whensungoesdown/soc1/tb/testasmcode.txt

addi x5, x0, 0
addi x6, x0, 0
addi x7, x0, 100

loop:
addi x6, x6, 1
add x5, x5, x6
bne x6, x7, loop

sw x5, 0x50(x0)
addi x0, x0, 0
addi x0, x0, 0
halt:
addi x0, x0, 0
beq x0,x0, halt
