whensungoesdown/soc1/soc/cpu6/cpu6_core.v

`include "defines.v"

module cpu6_core (
   input  clk,
   input  reset,

   output [`CPU6_XLEN-1:0] pcF,
   input  [`CPU6_XLEN-1:0] instr,
   // write back to memory
   output memwriteM,
   output [`CPU6_XLEN-1:0] dataaddr,
   output [`CPU6_XLEN-1:0] writedata,
   // fetch data
   input  [`CPU6_XLEN-1:0] readdata,

   output csr_mtie_r,
   output csr_meie_r,
   input  tmr_irq_r,
   input  ext_irq_r
);

   wire memwrite;
   wire memtoreg;
   wire alusrc;
   //wire regdst;
   wire regwrite;
   wire jump;
   wire [`CPU6_BRANCHTYPE_SIZE-1:0] branchtype;
   wire zero;

   wire [`CPU6_ALUCONTROL_SIZE-1:0] alucontrol;   
   wire alusignext;
   wire [`CPU6_IMMTYPE_SIZE-1:0] immtype;

   wire [`CPU6_XLEN-1:0] instrF;

   wire memwriteE;
   wire memtoregE;
   wire [`CPU6_BRANCHTYPE_SIZE-1:0] branchtypeE;
   wire alusrcE;
   wire regwriteE;
   wire jumpE;
   wire [`CPU6_ALUCONTROL_SIZE-1:0] alucontrolE;
   wire alusignextE;
   wire [`CPU6_IMMTYPE_SIZE-1:0] immtypeE;
   wire [`CPU6_XLEN-1:0] instrE;


   wire [`CPU6_XLEN-1:0] pcplus4F;
   wire [`CPU6_XLEN-1:0] pcnextF;

   wire [`CPU6_XLEN-1:0] pcE;
   wire [`CPU6_XLEN-1:0] pcnextE;
   wire pcsrcE;

   wire hazard_stallF;
   wire empty_pipeline_stallF;
   // empty pipeline
   wire empty_pipeline_req;
   wire empty_pipeline_reqE;
   wire empty_pipeline_ackW;
   

   wire stallF;
   wire flashE;

   wire hazard_flashE;


   wire [`CPU6_LSWIDTH_SIZE-1:0] lswidth;  // for LW LH LB, SW SH SB
   wire loadsignext; // for LHU LBU

   wire [`CPU6_LSWIDTH_SIZE-1:0] lswidthE;  // for LW LH LB, SW SH SB
   wire loadsignextE; // for LHU LBU

   
   wire jal;  // instruction jal, goes to EX
   wire lui;  // instruction lui, goes to EX
   wire auipc; // instruction auipc, goes to EX

   wire jalE;
   wire luiE;
   wire auipcE;
   wire [`CPU6_XLEN-1:0] pc_auipcE;
   
   wire mret;
   
   wire excp_illinstr;
   wire excp_flush_pc_ena;
   wire [`CPU6_XLEN-1:0] excp_flush_pc;

   wire [`CPU6_XLEN-1:0] excp_mepc;
   wire excp_mepc_ena;

   wire [`CPU6_XLEN-1:0] excp_pc;

   wire [`CPU6_XLEN-1:0] csr_mtvec;
   
   wire [`CPU6_XLEN-1:0] csr_mepc;

   wire csr_mstatus_mie_r;

   wire shft_en;
   wire shft_lr;
   wire shft_la;
   
   wire shft_enE;
   wire shft_lrE;
   wire shft_laE;


   
   cpu6_excp excp(
      .clk              (clk     ),
      .reset            (reset   ),
      .excp_pc          (excp_pc ),
      
      .excp_illinstr        (excp_illinstr    ),
      .tmr_irq_r            (tmr_irq_r        ),
      .ext_irq_r            (ext_irq_r        ),
      .csr_mstatus_mie_r    (csr_mstatus_mie_r),
      
      .excp_flush_pc_ena    (excp_flush_pc_ena),
      .excp_flush_pc        (excp_flush_pc    ),
      .excp_mepc            (excp_mepc        ),
      .excp_mepc_ena        (excp_mepc_ena    ),
      .csr_mtvec            (csr_mtvec        )
      );
       

   
   cpu6_hazardcontrol hazardcontrol(branchtype, jump, branchtypeE, jumpE, pcsrcE,
      hazard_stallF, hazard_flashE);


   assign empty_pipeline_stallF = empty_pipeline_req & (~empty_pipeline_ackW);
   
   //assign stallF = hazard_stallF | empty_pipeline_stallF;
   assign stallF = (~excp_flush_pc_ena & (hazard_stallF | empty_pipeline_stallF));


   // for interrupt, after trap handler, the faulting pc will be re-executed
   // so here, since the instruction is already fetched, 
   // Replace it with NOP
   assign instrF = (csr_mstatus_mie_r & (tmr_irq_r | ext_irq_r)) ? `NOP : instr;
   
   assign flashE = hazard_flashE;
   
   cpu6_dfflr#(`CPU6_XLEN) pcreg(!stallF, pcnextF, pcF, ~clk, reset);
   
   // It is a trick, pcF updated in the *falling edge* in order to be ahead of time,
   // so that pcF is ready for the RAM when the rasing edge comes.
   // But other modules such as cpu6_excp still works on the rasing edge.
   // When excp sends the pcF to csr to write, the pcF is already updated in the previous
   // falling edge. So there have to be an extra pc to store the previous pcF value. 
   cpu6_dfflr#(`CPU6_XLEN) excp_pc_reg(!stallF, pcF, excp_pc, ~clk, reset);
   
   cpu6_adder pcadd4(pcF, 32'b100, pcplus4F); // next pc if no branch, no jump
   
  
   
   //cpu6_mux2#(`CPU6_XLEN) pcnextmux(pcplus4F, pcnextE, pcsrcE, pcnextF);
   // 1. excp_flush has the highest priority. For example, illegal instruction, the excp module
   //    need to set pc to trap vector.
   // 2. There is a branch, the branch pc comes from EX stage because it needs calculation
   // 3. pc+4  
   assign pcnextF =
		    mret              ? csr_mepc      :
		    excp_flush_pc_ena ? excp_flush_pc :
		    pcsrcE            ? pcnextE       :
		    pcplus4F;

   assign empty_pipeline_req = mret | excp_flush_pc_ena; // (excp_active);

   // csr
   wire csr;
   wire csr_rs1uimm;
   wire [`CPU6_CSR_WSC_SIZE-1:0] csr_wsc;

   // csr signal pass to datapath IDEX
   wire csrE;
   wire csr_rs1uimmE;
   wire [`CPU6_CSR_WSC_SIZE-1:0] csr_wscE;
   //


   
   cpu6_controller c(
      .op             (instrF[`CPU6_OPCODE_HIGH:`CPU6_OPCODE_LOW]),
      .funct3         (instrF[`CPU6_FUNCT3_HIGH:`CPU6_FUNCT3_LOW]),
      .funct7         (instrF[`CPU6_FUNCT7_HIGH:`CPU6_FUNCT7_LOW]),

      .lswidth        (lswidth        ),
      .loadsignext    (loadsignext    ),
      
      .jal            (jal            ),
      .lui            (lui            ),
      .auipc          (auipc          ),
      .mret           (mret           ),
      // csr
      .csr            (csr            ),
      .csr_rs1uimm    (csr_rs1uimm    ),
      .csr_wsc        (csr_wsc        ),
      //
      .memtoreg       (memtoreg       ),
      .memwrite       (memwrite       ),
      .branchtype     (branchtype     ),
      .alusrc         (alusrc         ),
      .regwrite       (regwrite       ),
      .jump           (jump           ),
      .alucontrol     (alucontrol     ),
      .alusignext     (alusignext     ),
      .immtype        (immtype        ),
      .illinstr       (excp_illinstr  ),

      .shft_en        (shft_en        ),
      .shft_lr        (shft_lr        ),
      .shft_la        (shft_la        )
      );

   
   //
   // To flash the pipeline register, signal flashE. 
   // If no flash pipelinereg_idex, this branch instruction will go through the pipeline
   // twice, so it will branch twice, then the following instruction will also be
   // executed twice.
   // So, need flashE, but not by reset, set an flash signal, it makes a bubble into
   // pipeline_idex in the next clock cycle.
   //
   
   cpu6_pipelinereg_idex pipelinereg_idex(
      .clk              (clk            ),
      .reset            (reset          ),
      .flash            (flashE         ),

      .lswidth          (lswidth        ),
      .loadsignext      (loadsignext    ),
      
      .jal              (jal            ),
      .lui              (lui            ),
      .auipc            (auipc          ),
      .pc_auipc         (excp_pc        ),
      // csr
      .csr              (csr            ),
      .csr_rs1uimm      (csr_rs1uimm    ),
      .csr_wsc          (csr_wsc        ),
      //
      .memwrite         (memwrite       ),
      .memtoreg         (memtoreg       ),
      .branchtype       (branchtype     ),
      .alusrc           (alusrc         ),
      .regwrite         (regwrite       ),
      .jump             (jump           ),
      .alucontrol       (alucontrol     ),
      .alusignext       (alusignext     ),
      .immtype          (immtype        ),
      .pc               (pcF            ),
      .instrF           (instrF         ),
      .empty_pipeline_req  (empty_pipeline_req ),
      
      .shft_en          (shft_en        ),
      .shft_lr          (shft_lr        ),
      .shft_la          (shft_la ),
      

      .lswidthE         (lswidthE       ),
      .loadsignextE     (loadsignextE   ),
      
      .jalE             (jalE           ),
      .luiE             (luiE           ),
      .auipcE           (auipcE         ),
      .pc_auipcE        (pc_auipcE      ),
      // csr
      .csrE             (csrE           ),
      .csr_rs1uimmE     (csr_rs1uimmE   ),
      .csr_wscE         (csr_wscE       ),
      //
      .memwriteE        (memwriteE      ),
      .memtoregE        (memtoregE      ),
      .branchtypeE      (branchtypeE    ),
      .alusrcE          (alusrcE        ),
      .regwriteE        (regwriteE      ),
      .jumpE            (jumpE          ),
      .alucontrolE      (alucontrolE    ),
      .alusignextE      (alusignextE    ),
      .immtypeE         (immtypeE       ),
      .pcE              (pcE            ),
      .instrE           (instrE         ),
      .empty_pipeline_reqE (empty_pipeline_reqE ),

      .shft_enE         (shft_enE       ),
      .shft_lrE         (shft_lrE       ),
      .shft_laE         (shft_laE       )
      );
  
   cpu6_datapath dp(
      .clk          (clk      ),
      .reset        (reset    ),
      .memwriteE    (memwriteE    ),
      .memtoregE    (memtoregE    ),
      .branchtypeE  (branchtypeE  ),
      .alusrcE      (alusrcE      ),
      .regwriteE    (regwriteE    ),
      .jumpE        (jumpE        ),
      .alucontrolE  (alucontrolE  ),
      .alusignextE  (alusignextE  ),
      .immtypeE     (immtypeE     ),
      .pcE          (pcE      ),
      .pcnextE      (pcnextE  ),
      .pcsrcE       (pcsrcE   ),
      .instrE       (instrE   ),


      .lswidthE     (lswidthE     ),
      .loadsignextE (loadsignextE ),
      
      .jalE         (jalE         ),
      .luiE         (luiE         ),
      .auipcE       (auipcE       ),
      .pc_auipcE    (pc_auipcE    ), // the current pc value for EX stage, just for the use of auipc instruction
      // csr
      .csrE         (csrE         ),
      .csr_rs1uimmE (csr_rs1uimmE ),
      .csr_wscE     (csr_wscE     ),

      .csr_mtvec    (csr_mtvec    ),
      .csr_mepc     (csr_mepc     ),
      
      .excp_mepc    (excp_mepc    ),
      .excp_mepc_ena(excp_mepc_ena),
      
      // empty pipline req ack
      .empty_pipeline_reqE  (empty_pipeline_reqE  ),
      .empty_pipeline_ackW (empty_pipeline_ackW ),
      //
      .dataaddrM    (dataaddr     ),
      .writedataM   (writedata    ),
      .readdata_rawM(readdata     ),
      .memwriteM    (memwriteM    ),

      .tmr_irq_r    (tmr_irq_r    ),
      .ext_irq_r    (ext_irq_r    ),
      .csr_mtie_r   (csr_mtie_r   ),
      .csr_meie_r   (csr_meie_r   ),
      .csr_mstatus_mie_r (csr_mstatus_mie_r),
      .mret_ena     (mret         ), // execute mret instruction, 
                                     // mret does not go down the pipeline further than D

      .shft_enE     (shft_enE     ),
      .shft_lrE     (shft_lrE     ),
      .shft_laE     (shft_laE     )
      );
endmodule   
