whensungoesdown/soc1/soc/cpu6/defines.v

`define CPU6_ADDR_SIZE    32
//`define CPU6_PC_SIZE      32

`define NOP               32'h00000000

`define CPU6_RFREG_NUM    32
`define CPU6_RFIDX_WIDTH  5
`define CPU6_XLEN         32

`define CPU6_ALUCONTROL_SIZE     3
`define CPU6_ALUCONTROL_ADD      3'b010
`define CPU6_ALUCONTROL_SUB      3'b110
`define CPU6_ALUCONTROL_AND      3'b000
`define CPU6_ALUCONTROL_OR       3'b001
`define CPU6_ALUCONTROL_SLT      3'b111
`define CPU6_ALUCONTROL_XOR      3'b011

`define CPU6_ALUOP_SIZE          2
`define CPU6_ALUOP_LWSWJALR      2'b00
`define CPU6_ALUOP_BRANCH        2'b01
`define CPU6_ALUOP_ARITHMETIC    2'b10

`define CPU6_FUNCT3_HIGH         14
`define CPU6_FUNCT3_LOW          12
`define CPU6_FUNCT3_SIZE          3

`define CPU6_FUNCT7_HIGH         31
`define CPU6_FUNCT7_LOW          25
`define CPU6_FUNCT7_SIZE          7

`define CPU6_RS2_HIGH            24
`define CPU6_RS2_LOW             20

`define CPU6_RS1_HIGH            19
`define CPU6_RS1_LOW             15

`define CPU6_RD_HIGH             11
`define CPU6_RD_LOW               7

// IMM
`define CPU6_IMMTYPE_SIZE        3

`define CPU6_IMMTYPE_R           3'b000
`define CPU6_IMMTYPE_I           3'b001
`define CPU6_IMMTYPE_S           3'b010
`define CPU6_IMMTYPE_B           3'b011
`define CPU6_IMMTYPE_U           3'b100
`define CPU6_IMMTYPE_J           3'b101


// I-type imm
`define CPU6_I_IMM_HIGH          31
`define CPU6_I_IMM_LOW           20
`define CPU6_I_IMM_SIZE          12

// S-type imm
`define CPU6_S_IMM2_HIGH         31
`define CPU6_S_IMM2_LOW          25
`define CPU6_S_IMM1_HIGH         11
`define CPU6_S_IMM1_LOW           7
`define CPU6_S_IMM_SIZE          12 

// B-type imm
`define CPU6_B_IMM_BIT12         31
`define CPU6_B_IMM_BIT11          7
`define CPU6_B_IMM2_HIGH         30
`define CPU6_B_IMM2_LOW          25
`define CPU6_B_IMM1_HIGH         11
`define CPU6_B_IMM1_LOW           8
`define CPU6_B_IMM_SIZE          13

// U-type imm
`define CPU6_U_IMM_HIGH          31
`define CPU6_U_IMM_LOW           12
`define CPU6_U_IMM_SIZE          20



`define CPU6_OPCODE_HIGH          6
`define CPU6_OPCODE_LOW           0
`define CPU6_OPCODE_SIZE          7


// Branch 
`define CPU6_BRANCHTYPE_SIZE      3

// BRANCHTYPE similar to funct3, use 3'b010 as nobranch
// need to make NOBRANCH 000, because that's in the register pipeline
//`define CPU6_BRANCHTYPE_NOBRANCH  3'b010
`define CPU6_BRANCHTYPE_NOBRANCH  3'b000

//`define CPU6_BRANCHTYPE_BEQ       3'b000
`define CPU6_BRANCHTYPE_BEQ       3'b010
`define CPU6_BRANCHTYPE_BNE       3'b001
`define CPU6_BRANCHTYPE_BLT       3'b100
`define CPU6_BRANCHTYPE_BGE       3'b101
`define CPU6_BRANCHTYPE_BLTU      3'b110
`define CPU6_BRANCHTYPE_BGEU      3'b111
// ...


// Exception
`define CPU6_MTVEC_TRAP_BASE      32'h00000004


// CSR
`define CPU6_CSR_SIZE             12

`define CPU6_CSR_WSC_SIZE         2
`define CPU6_CSR_WSC_W            2'b01
`define CPU6_CSR_WSC_S            2'b10
`define CPU6_CSR_WSC_C            2'b11  

`define CPU6_CSR_RS1              1'b0
`define CPU6_CSR_UIMM             1'b1


// LOAD STORE WIDTH
`define CPU6_LSWIDTH_SIZE         2
`define CPU6_LSWIDTH_W            2'b00
`define CPU6_LSWIDTH_H            2'b01
`define CPU6_LSWIDTH_B            2'b10
