whensungoesdown/soc1/soc/cpu6/cpu6_alu.v

`include "defines.v"

module cpu6_alu (
   input  [`CPU6_XLEN-1:0] a,
   input  [`CPU6_XLEN-1:0] b,
   input  [`CPU6_ALUCONTROL_SIZE-1:0] control,
   input  signext,
   output [`CPU6_XLEN-1:0] y,
   output zero,
   output lt
   );
   
   wire control_add;
   wire control_sub;
   wire control_and;
   wire control_or;
   wire control_slt;
   wire control_xor;


   wire [`CPU6_XLEN:0] signext_a;
   wire [`CPU6_XLEN:0] signext_b;
   wire [`CPU6_XLEN:0] signext_b2;  // 2's complement
   
   wire [`CPU6_XLEN:0] add_result;
   wire [`CPU6_XLEN:0] sub_result;
   wire [`CPU6_XLEN-1:0] and_result;
   wire [`CPU6_XLEN-1:0] or_result;
   wire [`CPU6_XLEN-1:0] slt_result;
   wire [`CPU6_XLEN-1:0] xor_result;

   assign signext_a[32:0] = {signext & a[31], a[31:0]};
   assign signext_b[32:0] = {signext & b[31], b[31:0]};
   assign signext_b2[32:0] = ~signext_b + 1'b1;
   
   assign control_add = (control[`CPU6_ALUCONTROL_SIZE-1:0] == `CPU6_ALUCONTROL_ADD);
   assign control_sub = (control[`CPU6_ALUCONTROL_SIZE-1:0] == `CPU6_ALUCONTROL_SUB);
   assign control_and = (control[`CPU6_ALUCONTROL_SIZE-1:0] == `CPU6_ALUCONTROL_AND);
   assign control_or  = (control[`CPU6_ALUCONTROL_SIZE-1:0] == `CPU6_ALUCONTROL_OR);
   assign control_slt = (control[`CPU6_ALUCONTROL_SIZE-1:0] == `CPU6_ALUCONTROL_SLT);
   assign control_xor = (control[`CPU6_ALUCONTROL_SIZE-1:0] == `CPU6_ALUCONTROL_XOR);
   
   //assign add_result = a + b;
   //assign sub_result = a - b;
   assign add_result = signext_a + signext_b;
   assign sub_result = signext_a + signext_b2;
   
   assign and_result = a & b;
   assign or_result  = a | b;
   //assign slt_result = a < b ? 1 : 0;
   assign xor_result  = a ^ b;
   
   //assign zero = (control_add & (add_result == `CPU6_XLEN'b0))
   //   | (control_sub & (sub_result == `CPU6_XLEN'b0))
   //	 ;

   assign zero = (sub_result == 32'b0);

   assign slt_result = {31'b0, sub_result[32]};
   assign lt = slt_result[0];
   
   assign y = ({`CPU6_XLEN{control_add}} & add_result[31:0])
            | ({`CPU6_XLEN{control_sub}} & sub_result[31:0])
	    | ({`CPU6_XLEN{control_and}} & and_result)
	    | ({`CPU6_XLEN{control_or}}  & or_result)
	    | ({`CPU6_XLEN{control_slt}} & slt_result)
	    | ({`CPU6_XLEN{control_xor}} & xor_result)
		     ;
   
   
endmodule
