whensungoesdown/soc1/(commit log)

2020-08-02 Submit files, doesn't compile yet
    [cpu6_alu.v, cpu6_aludec.v, cpu6_branchdec.v, cpu6_controller.v, cpu6_core.v, cpu6_datapath.v, cpu6_dffs.v]
2020-08-02 it works. assign pin locations in makefile. Successfully run it on FPGA board C4E6E10.
2020-08-03 bug fix: jalr opcode 1100111
    [cpu6_maindec.v]
2020-08-03 bugfix: top->soc_top in tb file
    [soc_top_tb.v]
2020-08-03 add simulation script
    simulation/soc1 is a testbench for the whole soc1.
    soc1.sh is the script to run the simulation.
    soc1.f is the file list that add to the simulation and compiled,
    Note: alter_mf.v also added in this file.
    soc1.wlf file can be viewed: vsim -view soc1.wlf
    Because the simulation modelsim is separate from quartus,
    so the simulation project need the ram initialize file in
    the current work directory, which is good, so that each test
    case can have its own memory(code & data). The ram.mif and
    vgaram.mif is for the this soc1 simulation.
    need more work to add monitored signal and other tcl stuff.
    Later, add more test cases under simulation diretory.
2020-08-04 simulation test framework
    testbenches are all based on soc_top.
    run_all_tests.sh records all the test simulation to run,
    not inlcuding soc1.
    To add new test case, create the similiar testbench file in ../tb/
    e.g. test1_addi uses ../tb/test1_addi_soc_top_tb.v
    The file name is stored in files.f
    To add signals, add stuff in sim.do.
    Each new test case has its own ram.mif as the cpu memory
    in their directory.
    In testbench, if the case succeed, $display "simluation SUCCESS"
    or "simluation FAILED". The run_all_tests.sh will grep "simluation"
    to show the result.
    [test1_addi_soc_top_tb.v]
2020-08-04 change doc/cpu_clk.md to doc/test1_addi.md, fix typo
    [test1_addi_soc_top_tb.v]
2020-08-04 Add new simulation test test2_addi_cpu_clk_initial_1
    See doc/test1_addi
    this case should fail, it proves that if the very first
    instruction at pc 0x0 get filled into pipeline twice, it will
    affect the result. (in this testbench, cpu_clk init to 1)
    The timing of reset_n pull high is critical. It should be a little
    behind a clk rising edge.
    Not sure if the "reg cpu_clk" is initialized to 0 when runs on real
    fpga.
    Need to figure out a mechanism to solve this.
    [test2_addi_cpu_clk_initial_1_soc_top_tb.v]
2020-08-04 Change test2_addi.. code, add doc/test2_addi_cpu_clk_initial_1.md
    To better show staged instrE in the pipeline.
    Add signal wave instrE to result.wlf
2020-09-07 Add exception -- illegal instruction. reset vector at 0x0, trap vector at 0x4
    add module cpu6_excp
    no csr register read/write implemented, so the mtvec(trap vector) is hardcoded to 0x4.
    add simulation test case test4_exception_illegal_instruction.
    mcause mepc mtval not implemented yet, need cpu6_csr module.
    it should be outside of cpu6_excp, because interrupts also need it.
    [cpu6_controller.v, cpu6_core.v, cpu6_excp.v, cpu6_maindec.v, defines.v, test4_exception_illegal_instruction_soc_top_tb.v]
2020-09-30 new instruction csrrs
    Bug fix:
    csr register read and write at the same clock cycle. So the read
    will always get the write_dat.
    add cpu6_2x_dfflr module, double the register, therefore the read
    get old value, and write new value. The new value can be read in
    next cycle.
    Other option:
    For csr register, the read and write also put into separate stages
    of the pipiline. For example, read at MEM, write at WB stage.
    In this way, it may also neet to handle data harazd.
    [cpu6_csr.v, cpu6_datapath.v, cpu6_dffs.v, cpu6_maindec.v, test7_csrrs_soc_top_tb.v]
2020-10-02 bug fix: CSRRWI CSRRSI CSRRCI control signals typo
    add test9_csrrwi test case
    [cpu6_datapath.v, cpu6_maindec.v, test9_csrrwi_soc_top_tb.v]
2020-10-05 add mret, it works with known bug
    The instruction before mret, if it writes mepc, the value
    will not be updated in time.
    [cpu6_controller.v, cpu6_core.v, cpu6_csr.v, cpu6_datapath.v, cpu6_maindec.v]
2020-10-05 add mret and empty pipe singals
    add mret instruction and test13_mret
    Found a problem. When the mret is decoded in the IFID stage,
    the pcF will be filled with mepc. I choose to do this at IFID stage
    rather than do it in a later stage such as EX or MEM.
    The problem is that the instruction right before mret may not
    be finished in time. For example, if this instruction is csrrw which
    updates mepc, the mret will still use the old mepc.
    Such as the flowing code that tries to return from the trap handler.
    <trap>:
    00a00313; -- addi x6 x0 10
    341021f3; -- csrrs x3 mepc x0 (csrr rd mepc)
    00418193; -- addi x3 x3 4
    34119073; -- csrrw x0 mepc x3 (csrw mepc r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
    [cpu6_core.v, cpu6_datapath.v, cpu6_pipelinereg_exmem.v, cpu6_pipelinereg_idex.v, cpu6_pipelinereg_memwb.v, test13_mret_soc_top_tb.v]
2020-10-06 add test14_excp_write_mepc_finish_in_time
    I thought it was a bug that write to mepc right before an
    exception may not be able to finish in time.
    Or the excption set the mepc to PC before previous csrrw
    instruction.
    The csrrw instruction does finished before that the exception
    sends in the current PC to mepc.
    Later I had this empty pipeline mechanism. The exception will wait
    for all the instruction to finish, then jump to mtvec.
    [test14_excp_write_mepc_finish_in_time_soc_top_tb.v]
2020-10-13 update vga640x480 module
    updateram.sh
    add a script to update ram.mif and vgaram.mif
    no need to compile the whole project
    use the copy under the same directory of this script
    now the vga is in graphic mode,
    0x10000 is the first line of the screen, 0x1009f is the last spot.
    because 640 / 4 = 160
    then 0x10100 is the second line and so forth.
    0x10000 is the space of vgaram
    ---------------------
    now the ram.mif draw three blue pixel on the fifth line
    then enconter an illegal instruction
    the trap handler print a red pixel on the sixth line
2020-10-14 add vga text mode
    remove 640x480 graphic mode
    2KB RAM 0x10000-0x107FF
    640x400 70Hz 80x25 screen 8x16 pixel per character
    128 total ASCII characters
    if
    640x480 60Hz 80x30 screen 8x16 pixels 128 characters
    then
    need 4KB RAM
2020-12-09 Add lic local interrupt controller
    Now it only has the timer that run at the same frequency as the
    core does.
    Only mtime. It does not trigger interrupt yet.
    The device MMIO range is 0x20000 - 0x2FFFF
    mtime 0x20000
    mtimecmp 0x20004
    test15_read_mtime tests reading mtime at 0x20000.
    Read it twice.
    Need triggers interrupt next, and fill mcause.
    The testbench is slightly different than running on the FPGA.
    It may because of the first clock cycle on mtime register.
    The dnext and qout. For now it is ok.
2020-12-15 Forgot to submit lic/lic.v; Add csr mie mip
    mip is read-only
    mie is RW, only bit[7] mtie machine timer interrupt enable is used.
    All other bits are read-only with 0.
    add test18_read_write_csr_mie, set mie to 0x000000ff, then it
    should read as 0x00000080
2020-12-16 Implment timer; add test19_timer
    One thing to notice, when lic_timer_interrupt signaled,
    so does excp_flush_pc_ena also, then the pcnextF points to 0x4,
    the trap vector. Because when the timer bursts, the current
    instruction is the beq, therefore the stallF is also signaled.
    pcreg works on the clock falling edge, but the stallF prevent it
    from updating the trap vector.
    The excp_flush_pc_ena should override the harzard_stallF and
    empty_pipeline_stallF. In this case, it is the harazrd_stallF
    takes effect here because of the branch instruction.
    assign stallF = (~excp_flush_pc_ena &
    (hazard_stallF | empty_pipeline_stallF));
    I should document the hazardcontrol module.
    [cpu6_core.v, cpu6_csr.v, cpu6_datapath.v, cpu6_excp.v, lic.v, soc_top.v, test19_timer_soc_top_tb.v]
2020-12-16 Add files via upload
    add timer_test.png
2020-12-16 Add files via upload
    add timer_test.jpg
2021-01-01 try uart
    Add uart, only rx part works.
    Set the uart_rxd pin at PIN_114, which is the usb-uart's rx pin.
    Using IO pins also works, for instance, PIN_33
    systhesis/altera/c4e6e10pins sets the pin, but it needs to clean
    the soc_top project first. Therefore a clean.sh is added.
2021-01-01 try uart
    No interrupt yet. The systhesis/altera/ram.mif has the code to run
    the test. It keeps reading address 0x21000, which is the uart
    buffer (one byte) for now.
    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
2021-01-01 Let uart use the same clk as the core
2021-01-01 add uart tx
    tx PIN_113
    systhesis/altera/ram.mif is the test that read uartdr, then
    display it in the screen, then write it back to uartdr.
    Because it is in a loop, the uart terminal will get lots of
    repeated echo characters.
2021-01-02 add uart tx, interrupt
    add ext_irq_r to cpu6_core
    rams directory stores the ram files for the tests that can not use
    simulation to verify their results.
    For instance, rams/ram_uart_interrupt.mif takes inputs and sends
    back echo through uart. When receive data, uart raise ext_irq_r to
    singal the core.
    uartdr stands for UART Data Register, at address 0x21000
    The uart baudrate is fixed at 115200 8-bit data 1-bit stop, no
    parity bit.
    Read uartdr get the received one-byte data. Write uartdr sends it
    out through uart.
    [cpu6_core.v, cpu6_excp.v, soc_top.v]
2021-01-03 1. Set baudrate to 9600 2. Game Tic-Tac-Toe
    Through screen /dev/ttyUSB0 9600, pressing the direction arrow key
    sends four characters, for instance, <-[D as the left key.
    The interrupt for uart may reenter because there is no mechanism to
    prevent that yet.
    Game Tic-Tac-Toe
    systhesis/altera/rams/ram_tic_tac_toe.s
    systhesis/altera/rams/ram_tic_tac_toe.mif
2021-01-07 bug fix: assign ext_irq_r = rx_data_refresh;
    [soc_top.v]
2021-01-07 bug: the uart register should use the same cpu_clk with the core
    [soc_top.v]
2021-01-08 Fix tic-tac-toe freeze bug
    Press arrow keys too fast or keep pressing easily freeze the game.
    1. No mstatus.mie for global interrupt enabling.It also used to
    guarantee atomicity with respect to interrupt handlers. The
    interrupt reenters and corrupts the registers used by the previous
    trap handler.
    Add mstatus CSR register. mstatus.mie can be accessed through CSR
    instruction. When interrupt enable, once timer or uart interrupts
    raise, set mstatus.mie to 0; when mret returns back to faulting pc,
    set mstatus.mie back to 1.
    test20_mstatus_mie is for that.
    2. The exception is different from interrupt. When resuming from
    the trap handler, the core re-executes the faulting pc for the
    exception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
    [cpu6_core.v, cpu6_csr.v, cpu6_datapath.v, cpu6_excp.v, cpu6_pipelinereg_idex.v, defines.v, test20_mstatus_mie_soc_top_tb.v, test21_add1to4_interrupt_soc_top_tb.v]
2021-01-08 set uart baudrate to 115200
2021-01-12 Change mip.MTIP timer pending
    Now timer keeps pending until reseting mtime or mtimecmp in the
    If timer pending is not cleared, global interrupt mstatus.mie will
    keep 0, disabled.
    mtie_r now goes to lic module. lic sends out tmr_irq_r.
    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
    [cpu6_core.v, cpu6_excp.v, lic.v, soc_top.v, test19_timer_soc_top_tb.v, test22_mip.MTIP_soc_top_tb.v]
2021-01-12 Delete some comments
    tmr_irq_r and ext_irq_r do come out of registers
    tmr_irq_r is from mtime mtimecmp
    csr_mtie_r timer enable bit is sent to lic to decide whether
    to signal tmr_irq_r. ext_irq_r should be the same.
2021-01-12 If timer pending, then timer trap keeps coming back
    Now in cpu6_csr mret_ena has higher priority than ext_irq_r |
    tmr_irq_r. When mret instruction finishes, the mstatus.mie will be
    set to 1, global instruction enabled.
2021-01-17 add meie and meip
    change test20. As expected, it needs first enable external
    interrupt bit in mie.
2021-01-19 Add auipc instruction
    aupic needs imm+pc
    It is not easy to get the correct pc value because the way I
    handle pcF pcE and branch instruction makes it complicated.
    pcE changes at the falling edge, because the pcnextE value needs
    to be send out before the next raising edge, so that the pcF can
    be fetched in time.
    working on the falling edge is not a good idea.
    for auipc instruction, add pc_auipcE to cpu6_datapath. It is also
    updated at the falling edge but it is the previous value of pcE.
    excp_pc is used for exception to get the correct current pc.
    pc_auipcE is the correct pcE value for EX stage when handlign
    auipc instruction. It does change on the falling edge too.
    This is hard to unde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
    [cpu6_core.v, cpu6_datapath.v, cpu6_maindec.v, cpu6_pipelinereg_idex.v, test24_auipc_soc_top_tb.v]
2021-02-25 add instructiton jal
    add test43_jal test44_beq_jal test45_beq test46_jal2
    jal and auipc are different. They both need to add an imm to the
    current pc at EX stage. However, jal is a jump instruction. It
    assert stallF at IF stage. If stallF is asserted, pcnextF->pcF->
    excp_pc will be not be updated.
    At EX, auipc instruction uses the pc_auipcE which is excp_pc.
    pcE is one step faster than pc_auipcE. Because pcF are
    updated in the falling edge, it is always one step faster than the
    actual current pc at the next rasing edge. That is why I
    need excp_pc to be one step slower than pcF. It is used for
    exception handling and the aupic instruction.
    For jal, it is a jump. When stallF, excp_pc stops u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
    [cpu6_controller.v, cpu6_core.v, cpu6_datapath.v, cpu6_hazardcontrol.v, cpu6_immdec.v, cpu6_maindec.v, cpu6_pipelinereg_idex.v, defines.v]
2021-04-09 use C code, print helloworld
2021-04-10 tic-tac-toe enable external interrupt in both mstatus and mie
2021-05-31 soc1_loader test
    receives 16 byte from uart then print "Code uploaded."
2021-05-31 Add test case for SRAI.
    SRAI is an arithmetic right shift (the original sign bit is copied
    into the vacated upper bits).
2021-05-31 bootloader works
    It loads 1KB code from UART, and stores it to address 0x1000.
    Then the reset routine calls into entry 0x1000.
